cbscpe/PDP-11-CPU-V2-3/PDP-11-CPU-V2-3.kicad_pcb

## KiCad design PDP-11-CPU-V2-3.kicad_pcb (2026-11-02)

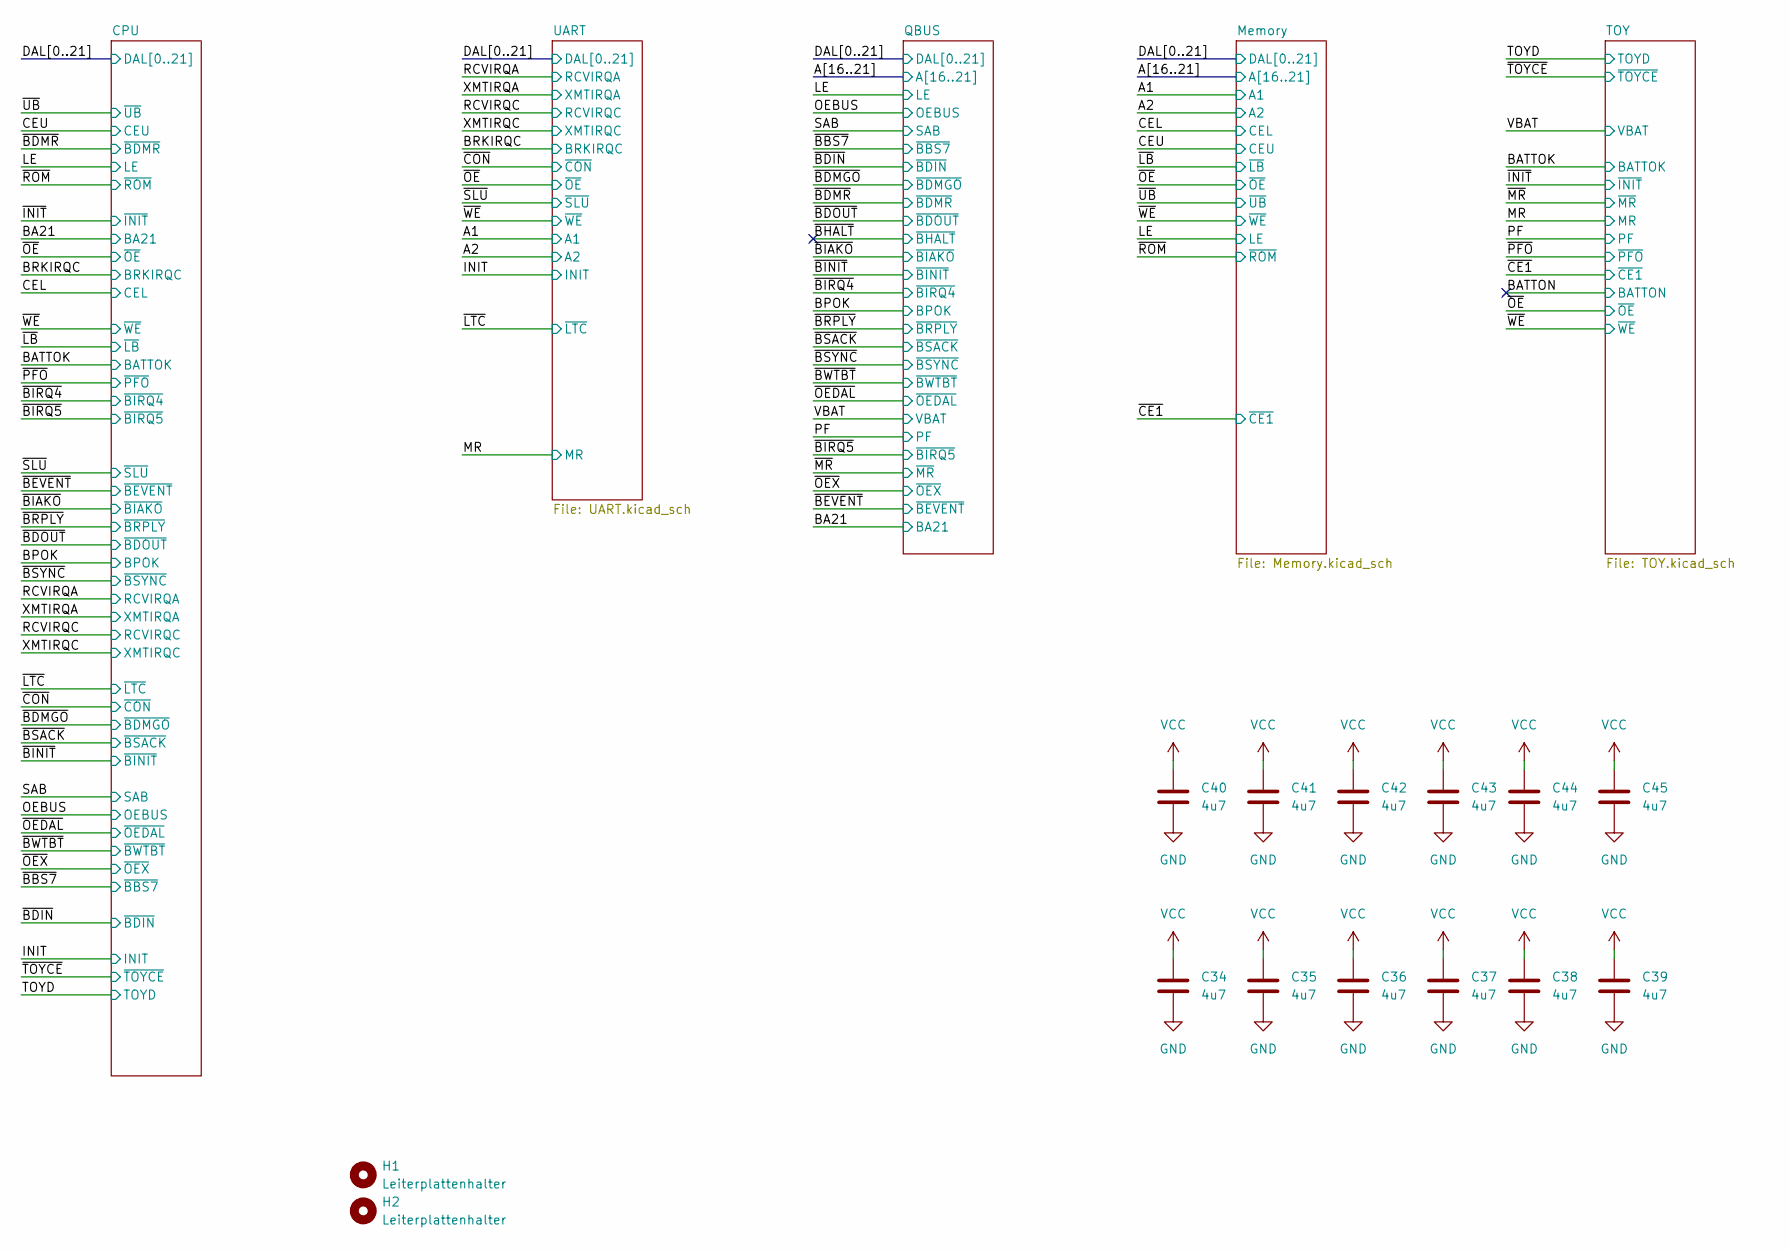
[picture p1: schematic PDP-11-CPU-V2-3.kicad_sch, Modular PDP-11/Hack CPU V2-3]

Parts:
C34, C35, C36, C37, C38, C39, C40, C41, C42, C43, C44, C45: 4u7; CP_EIA-3528-12_Kemet-T_HandSolder
H1, H2: Leiterplattenhalter; MountingHole_2.7mm_M2.5_DIN965

Connections:
GND: C34.2, C35.2, C36.2, C37.2, C38.2, C39.2, C40.2, C41.2, C42.2, C43.2, C44.2, C45.2; also elsewhere on the board
VCC: C34.1, C35.1, C36.1, C37.1, C38.1, C39.1, C40.1, C41.1, C42.1, C43.1, C44.1, C45.1; also elsewhere on the board

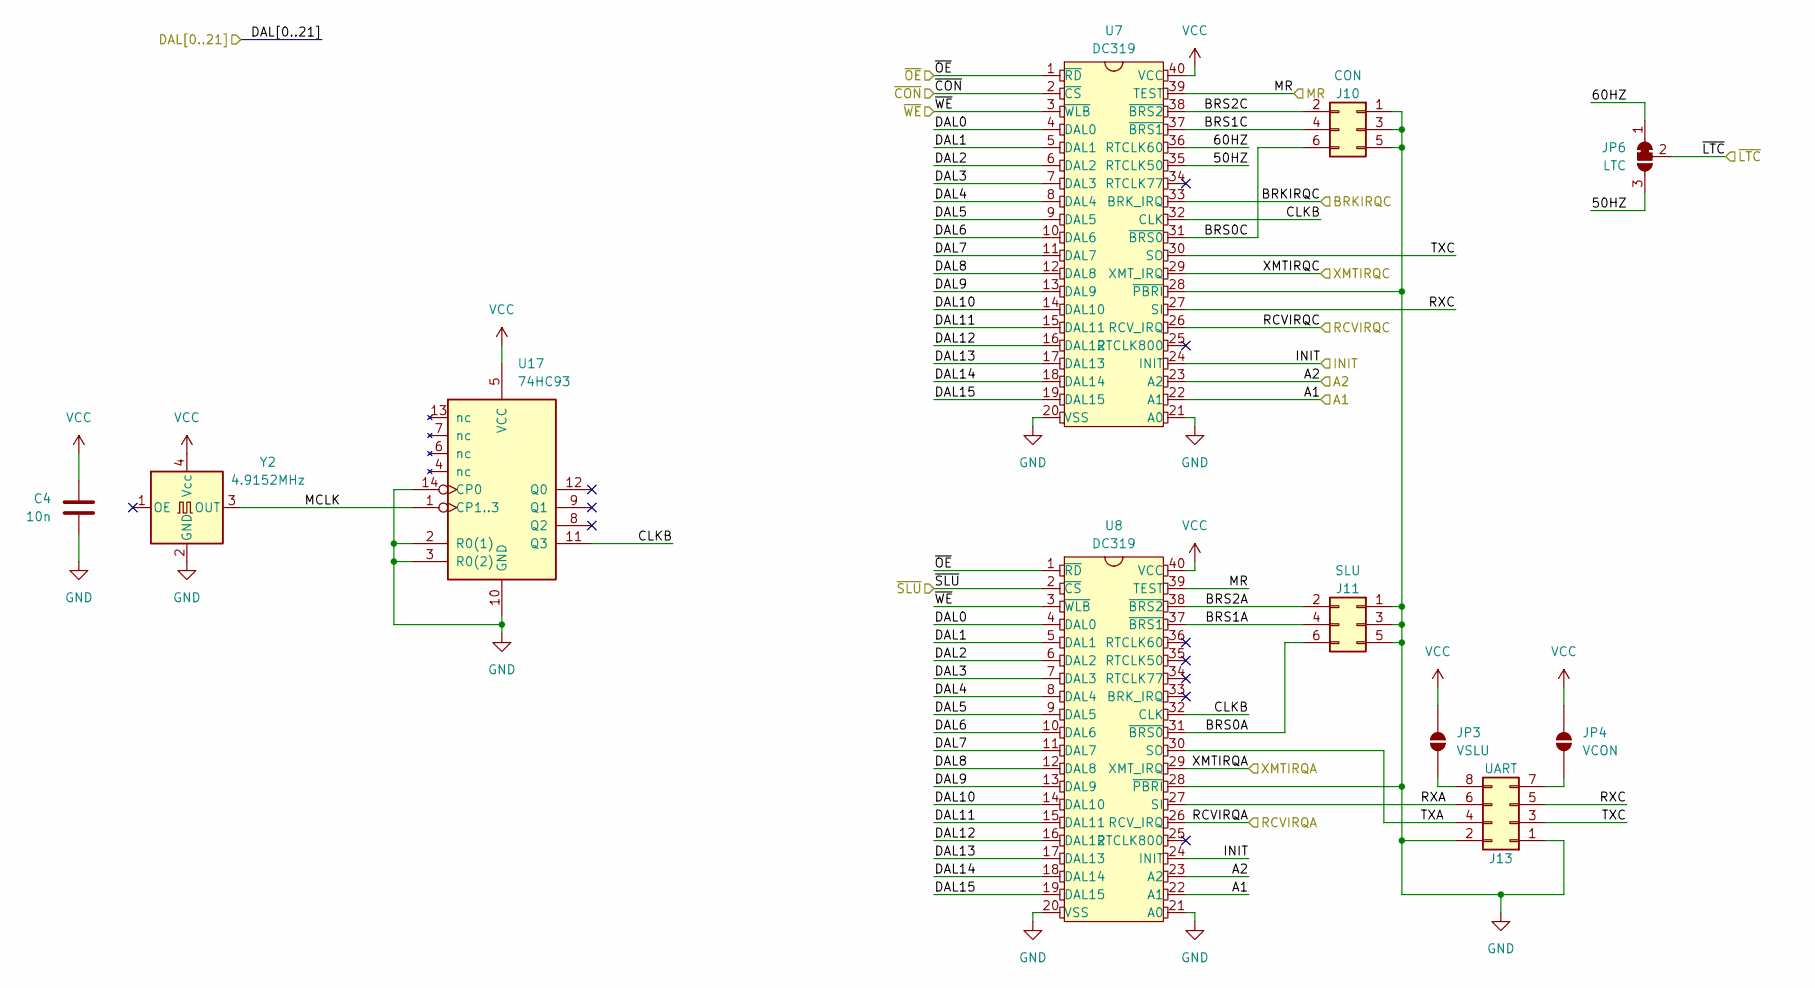
[picture p2: schematic UART.kicad_sch, Modular PDP-11/Hack CPU V2-3]

Parts:
C4: 10n; C_0603_1608Metric_Pad1.08x0.95mm_HandSolder
J10: CON; PinHeader_2x03_P2.54mm_Vertical
J11: SLU; PinHeader_2x03_P2.54mm_Vertical
J13: UART; PinHeader_2x04_P2.54mm_Horizontal
JP3: VSLU; SolderJumper-2_P1.3mm_Open_RoundedPad1.0x1.5mm
JP4: VCON; SolderJumper-2_P1.3mm_Open_RoundedPad1.0x1.5mm
JP6: LTC; SolderJumper-3_P1.3mm_Bridged12_RoundedPad1.0x1.5mm
U7, U8: DC319; DIP-40_W15.24mm_Socket
U17: 74HC93; SO-14_3.9x8.65mm_P1.27mm
Y2: 4.9152MHz; Oscillator_SMD_SeikoEpson_SG8002LB-4Pin_5.0x3.2mm_HandSolde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

Connections:
/A1: U7.22 (A1), U8.22 (A1); also elsewhere on the board
/A2: U7.23 (A2), U8.23 (A2); also elsewhere on the board
/BRKIRQC: U7.33 (BRK_IRQ); also elsewhere on the board
/DAL0: U7.4 (DAL0), U8.4 (DAL0); also elsewhere on the board
/DAL1: U7.5 (DAL1), U8.5 (DAL1); also elsewhere on the board
/DAL2: U7.6 (DAL2), U8.6 (DAL2); also elsewhere on the board
/DAL3: U7.7 (DAL3), U8.7 (DAL3); also elsewhere on the board
/DAL4: U7.8 (DAL4), U8.8 (DAL4); also elsewhere on the board
/DAL5: U7.9 (DAL5), U8.9 (DAL5); also elsewhere on the board
/DAL6: U7.10 (DAL6), U8.10 (DAL6); also elsewhere on the board
/DAL7: U7.11 (DAL7), U8.11 (DAL7); also elsewhere on the board
/DAL8: U7.12 (DAL8), U8.12 (DAL8); also elsewhere on the board
/DAL9: U7.13 (DAL9), U8.13 (DAL9); also elsewhere on the board
/DAL10: U7.14 (DAL10), U8.14 (DAL10); also elsewhere on the board
/DAL11: U7.15 (DAL11), U8.15 (DAL11); also elsewhere on the board
/DAL12: U7.16 (DAL12), U8.16 (DAL12); also elsewhere on the board
/DAL13: U7.17 (DAL13), U8.17 (DAL13); also elsewhere on the board
/DAL14: U7.18 (DAL14), U8.18 (DAL14); also elsewhere on the board
/DAL15: U7.19 (DAL15), U8.19 (DAL15); also elsewhere on the board
/INIT: U7.24 (INIT), U8.24 (INIT); also elsewhere on the board
/MR: U7.39 (TEST), U8.39 (TEST); also elsewhere on the board
/RCVIRQA: U8.26 (RCV_IRQ); also elsewhere on the board
/RCVIRQC: U7.26 (RCV_IRQ); also elsewhere on the board
/UART/50HZ: JP6.3 (B), U7.35 (RTCLK50)
/UART/60HZ: JP6.1 (A), U7.36 (RTCLK60)
/UART/BRS0A: J11.6, U8.31 (~BRS0)
/UART/BRS0C: J10.6, U7.31 (~BRS0)
/UART/BRS1A: J11.4, U8.37 (~BRS1)
/UART/BRS1C: J10.4, U7.37 (~BRS1)
/UART/BRS2A: J11.2, U8.38 (~BRS2)
/UART/BRS2C: J10.2, U7.38 (~BRS2)
/UART/CLKB: U7.32 (CLK), U8.32 (CLK), U17.11 (Q3)
/UART/MCLK: U17.1 (CP1..3), Y2.3 (OUT)
/UART/RXA: J13.6, U8.27 (SI)
/UART/RXC: J13.5, U7.27 (SI)
/UART/TXA: J13.4, U8.30 (SO)
/UART/TXC: J13.3, U7.30 (SO)
/XMTIRQA: U8.29 (XMT_IRQ); also elsewhere on the board
/XMTIRQC: U7.29 (XMT_IRQ); also elsewhere on the board
/~CON: U7.2 (~CS); also elsewhere on the board
/~LTC: JP6.2 (C); also elsewhere on the board
/~OE: U7.1 (~RD), U8.1 (~RD); also elsewhere on the board
/~SLU: U8.2 (~CS); also elsewhere on the board
/~WE: U7.3 (~WLB), U8.3 (~WLB); also elsewhere on the board
GND: C4.2, J10.1, J10.3, J10.5, J11.1, J11.3, J11.5, J13.1, J13.2, U7.20 (VSS), U7.21 (A0), U7.28 (~PBRI), U8.20 (VSS), U8.21 (A0), U8.28 (~PBRI), U17.2 (R0(1)), U17.3 (R0(2)), U17.10 (GND), U17.14 (CP0), Y2.2 (GND); also elsewhere on the board
unnamed: J13.7, JP4.1 (A)
unnamed: J13.8, JP3.1 (A)
VCC: C4.1, JP3.2 (B), JP4.2 (B), U7.40 (VCC), U8.40 (VCC), U17.5 (VCC), Y2.4 (Vcc); also elsewhere on the board

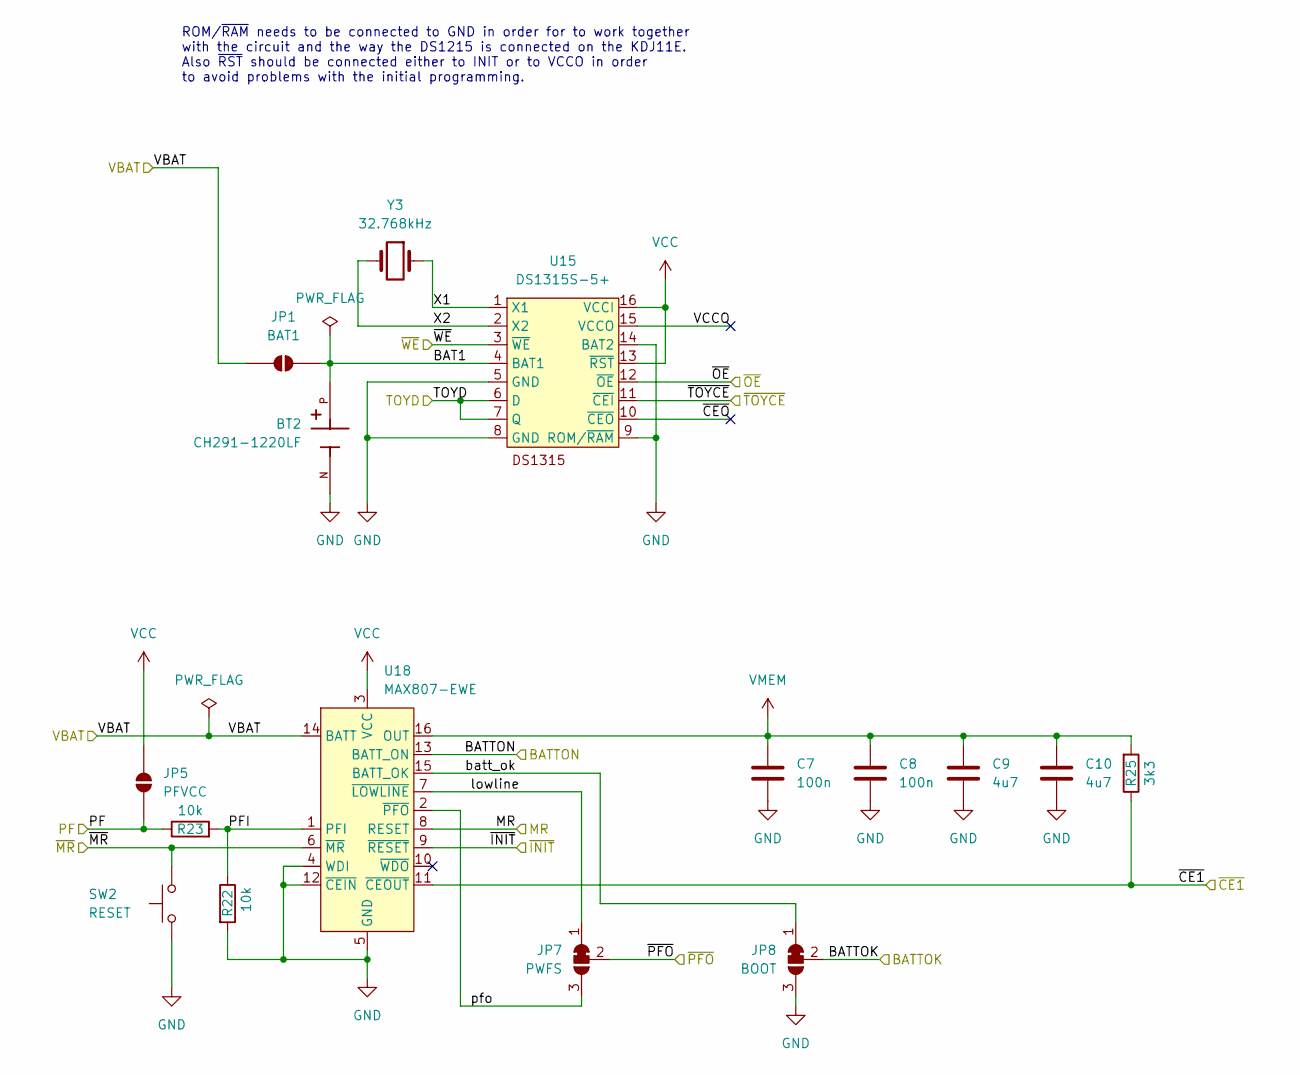
[picture p3: schematic TOY.kicad_sch, Modular PDP-11/Hack CPU V2-3]

Parts:
BT2: CH291-1220LF; BAT_CH291-1220LF
C7, C8: 100n; C_0603_1608Metric_Pad1.08x0.95mm_HandSolder
C9, C10: 4u7; CP_EIA-3528-12_Kemet-T_HandSolder
JP1: BAT1; SolderJumper-2_P1.3mm_Open_RoundedPad1.0x1.5mm
JP5: PFVCC; SolderJumper-2_P1.3mm_Open_RoundedPad1.0x1.5mm
JP7: PWFS; SolderJumper-3_P1.3mm_Bridged12_RoundedPad1.0x1.5mm
JP8: BOOT; SolderJumper-3_P1.3mm_Bridged12_RoundedPad1.0x1.5mm
R22, R23: 10k; R_0603_1608Metric_Pad0.98x0.95mm_HandSolder
R25: 3k3; R_0603_1608Metric_Pad0.98x0.95mm_HandSolder
SW2: RESET; SW_PUSH_6mm
U15: DS1315S-5+; SOIC-16W_7.5x10.3mm_P1.27mm
U18: MAX807-EWE; SOIC-16W_7.5x10.3mm_P1.27mm
Y3: 32.768kHz; Crystal_SMD_EuroQuartz_EQ161-2Pin_3.2x1.5mm_HandSoldering

Connections:
/BATTOK: JP8.2 (C); also elsewhere on the board
/BATTON: U18.13 (BATT_ON)
/MR: U18.8 (RESET); also elsewhere on the board
/PF: JP5.2 (B), R23.1; also elsewhere on the board
/TOY/BAT1: BT2.P, JP1.1 (A), U15.4 (BAT1)
/TOY/PFI: R22.1, R23.2, U18.1 (PFI)
/TOY/VCCO: U15.15 (VCCO)
/TOY/X1: U15.1 (X1), Y3.1
/TOY/X2: U15.2 (X2), Y3.2
/TOY/batt_ok: JP8.1 (A), U18.15 (BATT_OK)
/TOY/lowline: JP7.1 (A), U18.7 (~LOWLINE)
/TOY/pfo: JP7.3 (B), U18.2 (~PFO)
/TOY/~CEO: U15.10 (~CEO)
/TOYD: U15.6 (D), U15.7 (Q); also elsewhere on the board
/VBAT: JP1.2 (B), U18.14 (BATT); also elsewhere on the board
/~CE1: R25.1, U18.11 (~CEOUT); also elsewhere on the board
/~INIT: U18.9 (~RESET); also elsewhere on the board
/~MR: SW2.2, U18.6 (~MR); also elsewhere on the board
/~OE: U15.12 (~OE); also elsewhere on the board
/~PFO: JP7.2 (C); also elsewhere on the board
/~TOYCE: U15.11 (~CEI); also elsewhere on the board
/~WE: U15.3 (~WE); also elsewhere on the board
GND: BT2.N, C7.2, C8.2, C9.2, C10.2, JP8.3 (B), R22.2, SW2.1, U15.5 (GND), U15.8 (GND), U15.9 (ROM/~RAM), U15.14 (BAT2), U18.4 (WDI), U18.5 (GND), U18.12 (~CEIN); also elsewhere on the board
VCC: JP5.1 (A), U15.13 (~RST), U15.16 (VCCI), U18.3 (VCC); also elsewhere on the board
VMEM: C7.1, C8.1, C9.1, C10.1, R25.2, U18.16 (OUT); also elsewhere on the board

Notes on the sheet:
ROM/~{RAM} needs to be connected to GND in order for to work together with the circuit and the way the DS1215 is connected on the KDJ11E. Also ~{RST} should be connected either to INIT or to VCCO in order to avoid problems with the initial programming.

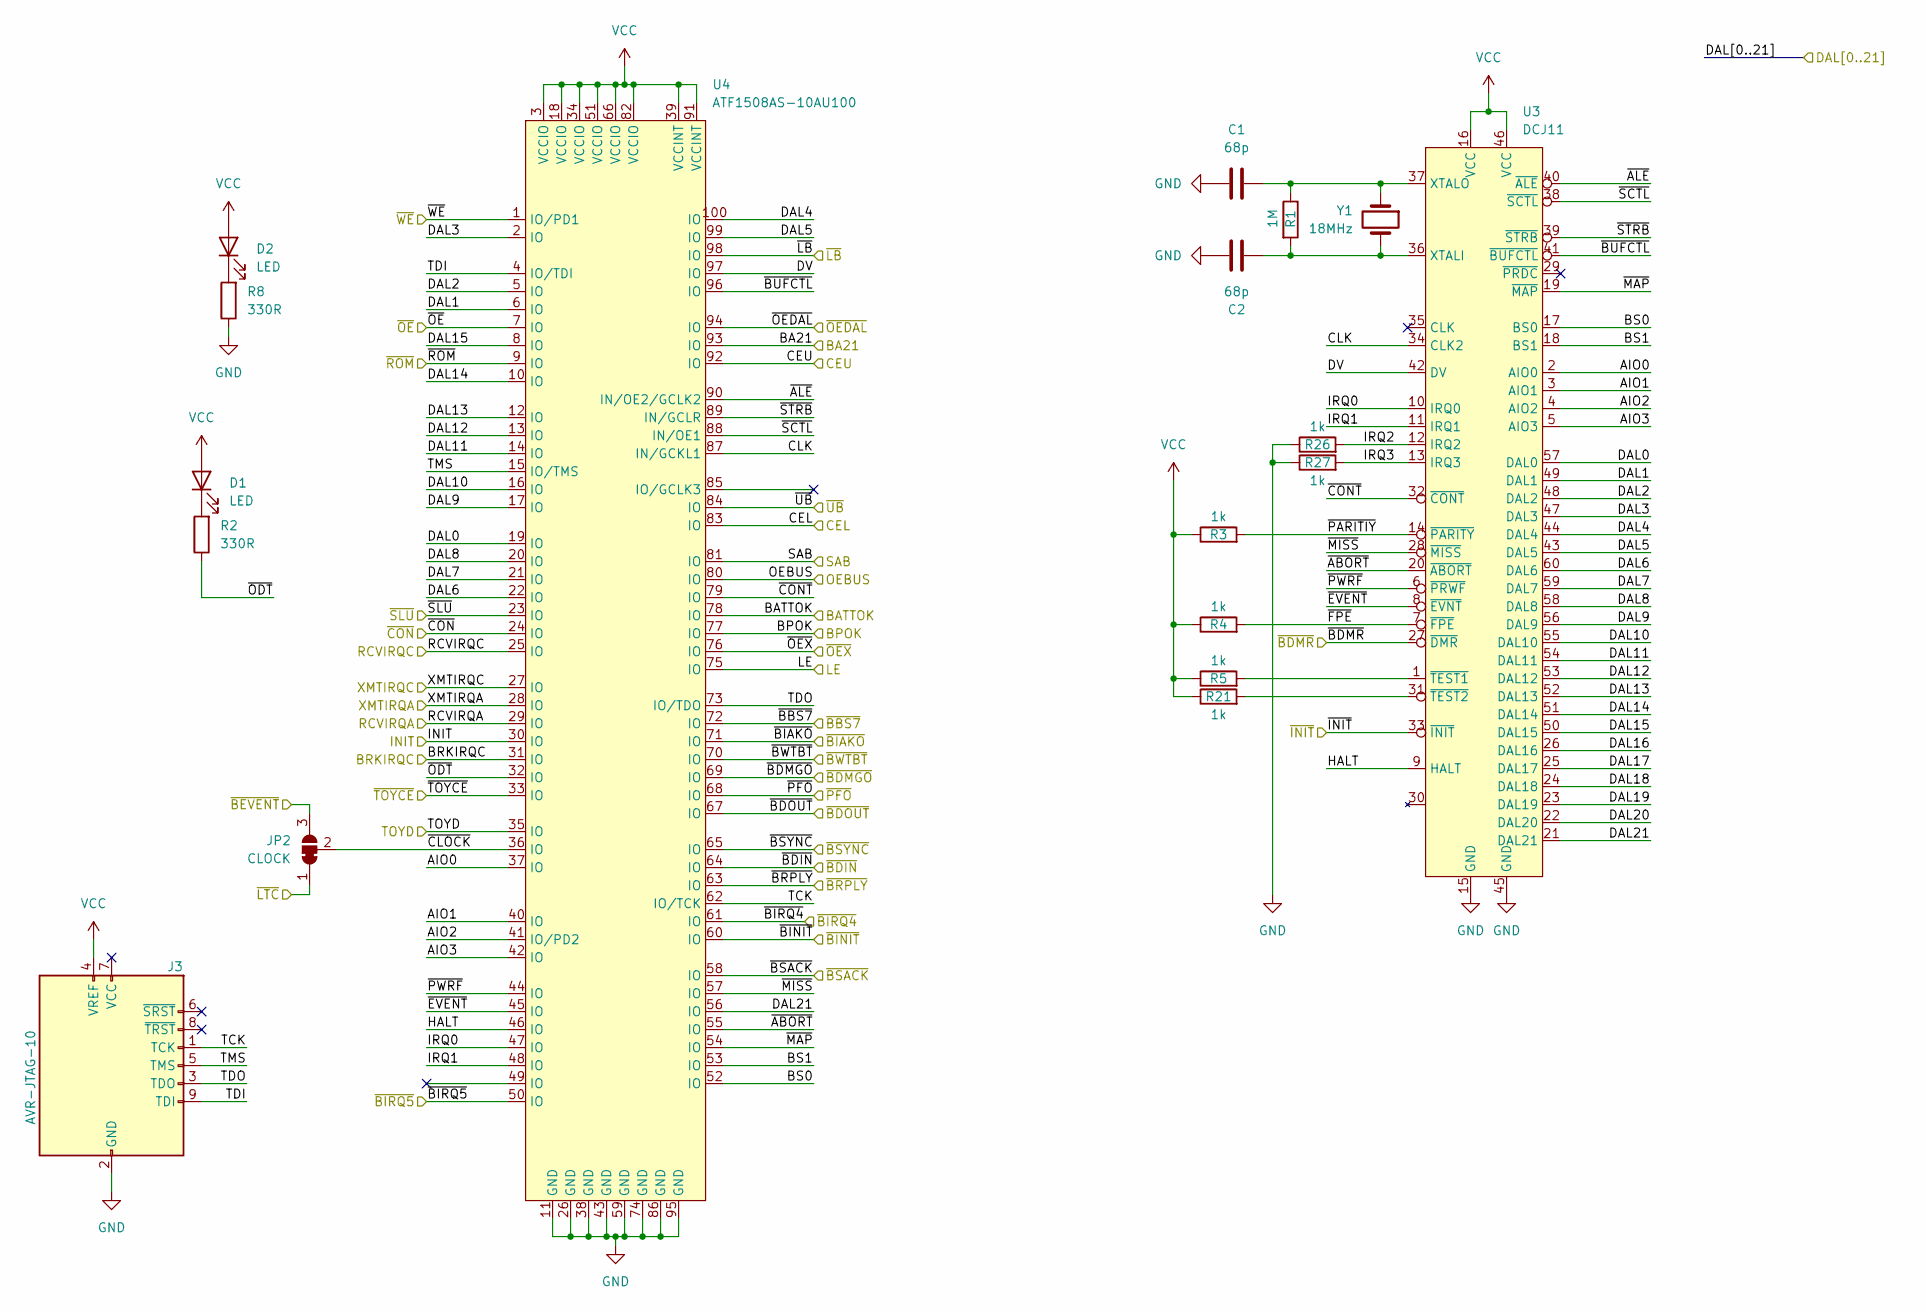
[picture p4: schematic CPU.kicad_sch, Modular PDP-11/Hack CPU V2-3]

Parts:
C1, C2: 68p; C_0603_1608Metric_Pad1.08x0.95mm_HandSolder
D1, D2: LED; LED_1206_3216Metric_Pad1.42x1.75mm_HandSolder
J3: AVR-JTAG-10; IDC-Header_2x05_P2.54mm_Horizontal
JP2: CLOCK; SolderJumper-3_P1.3mm_Bridged12_RoundedPad1.0x1.5mm
R1: 1M; R_0603_1608Metric_Pad0.98x0.95mm_HandSolder
R2, R8: 330R; R_0603_1608Metric_Pad0.98x0.95mm_HandSolder
R3, R4, R5, R21, R26, R27: 1k; R_0603_1608Metric_Pad0.98x0.95mm_HandSolder
U3: DCJ11; DIP-60_1300
U4: ATF1508AS-10AU100; TQFP-100_14x14mm_P0.5mm
Y1: 18MHz; Crystal_SMD_5032-2Pin_5.0x3.2mm_HandSoldering

Connections:
/BA21: U4.93 (IO); also elsewhere on the board
/BATTOK: U4.78 (IO); also elsewhere on the board
/BPOK: U4.77 (IO); also elsewhere on the board
/BRKIRQC: U4.31 (IO); also elsewhere on the board
/CEL: U4.83 (IO); also elsewhere on the board
/CEU: U4.92 (IO); also elsewhere on the board
/CPU/AIO0: U3.2 (AIO0), U4.37 (IO)
/CPU/AIO1: U3.3 (AIO1), U4.40 (IO)
/CPU/AIO2: U3.4 (AIO2), U4.41 (IO/PD2)
/CPU/AIO3: U3.5 (AIO3), U4.42 (IO)
/CPU/BS0: U3.17 (BS0), U4.52 (IO)
/CPU/BS1: U3.18 (BS1), U4.53 (IO)
/CPU/CLK: U3.34 (CLK2), U4.87 (IN/GCKL1)
/CPU/DV: U3.42 (DV), U4.97 (IO)
/CPU/HALT: U3.9 (HALT), U4.46 (IO)
/CPU/IRQ0: U3.10 (IRQ0), U4.47 (IO)
/CPU/IRQ1: U3.11 (IRQ1), U4.48 (IO)
/CPU/IRQ2: R26.2, U3.12 (IRQ2)
/CPU/IRQ3: R27.2, U3.13 (IRQ3)
/CPU/TCK: J3.1 (TCK), U4.62 (IO/TCK)
/CPU/TDI: J3.9 (TDI), U4.4 (IO/TDI)
/CPU/TDO: J3.3 (TDO), U4.73 (IO/TDO)
/CPU/TMS: J3.5 (TMS), U4.15 (IO/TMS)
/CPU/~ABORT: U3.20 (~ABORT), U4.55 (IO)
/CPU/~ALE: U3.40 (~ALE), U4.90 (IN/OE2/GCLK2)
/CPU/~BUFCTL: U3.41 (~BUFCTL), U4.96 (IO)
/CPU/~CLOCK: JP2.2 (C), U4.36 (IO)
/CPU/~CONT: U3.32 (~CONT), U4.79 (IO)
/CPU/~EVENT: U3.8 (~EVNT), U4.45 (IO)
/CPU/~FPE: R4.2, U3.7 (~FPE)
/CPU/~MAP: U3.19 (~MAP), U4.54 (IO)
/CPU/~MISS: U3.28 (~MISS), U4.57 (IO)
/CPU/~ODT: R2.1, U4.32 (IO)
/CPU/~PARITIY: R3.2, U3.14 (~PARITY)
/CPU/~PWRF: U3.6 (~PRWF), U4.44 (IO)
/CPU/~SCTL: U3.38 (~SCTL), U4.88 (IN/OE1)
/CPU/~STRB: U3.39 (~STRB), U4.89 (IN/GCLR)
/DAL0: U3.57 (DAL0), U4.19 (IO); also elsewhere on the board
/DAL1: U3.49 (DAL1), U4.6 (IO); also elsewhere on the board
/DAL2: U3.48 (DAL2), U4.5 (IO); also elsewhere on the board
/DAL3: U3.47 (DAL3), U4.2 (IO); also elsewhere on the board
/DAL4: U3.44 (DAL4), U4.100 (IO); also elsewhere on the board
/DAL5: U3.43 (DAL5), U4.99 (IO); also elsewhere on the board
/DAL6: U3.60 (DAL6), U4.22 (IO); also elsewhere on the board
/DAL7: U3.59 (DAL7), U4.21 (IO); also elsewhere on the board
/DAL8: U3.58 (DAL8), U4.20 (IO); also elsewhere on the board
/DAL9: U3.56 (DAL9), U4.17 (IO); also elsewhere on the board
/DAL10: U3.55 (DAL10), U4.16 (IO); also elsewhere on the board
/DAL11: U3.54 (DAL11), U4.14 (IO); also elsewhere on the board
/DAL12: U3.53 (DAL12), U4.13 (IO); also elsewhere on the board
/DAL13: U3.52 (DAL13), U4.12 (IO); also elsewhere on the board
/DAL14: U3.51 (DAL14), U4.10 (IO); also elsewhere on the board
/DAL15: U3.50 (DAL15), U4.8 (IO); also elsewhere on the board
/DAL16: U3.26 (DAL16); also elsewhere on the board
/DAL17: U3.25 (DAL17); also elsewhere on the board
/DAL18: U3.24 (DAL18); also elsewhere on the board
/DAL19: U3.23 (DAL19); also elsewhere on the board
/DAL20: U3.22 (DAL20); also elsewhere on the board
/DAL21: U3.21 (DAL21), U4.56 (IO)
/INIT: U4.30 (IO); also elsewhere on the board
/LE: U4.75 (IO); also elsewhere on the board
/OEBUS: U4.80 (IO); also elsewhere on the board
/RCVIRQA: U4.29 (IO); also elsewhere on the board
/RCVIRQC: U4.25 (IO); also elsewhere on the board
/SAB: U4.81 (IO); also elsewhere on the board
/TOYD: U4.35 (IO); also elsewhere on the board
/XMTIRQA: U4.28 (IO); also elsewhere on the board
/XMTIRQC: U4.27 (IO); also elsewhere on the board
/~BBS7: U4.72 (IO); also elsewhere on the board
/~BDIN: U4.64 (IO); also elsewhere on the board
/~BDMGO: U4.69 (IO); also elsewhere on the board
/~BDMR: U3.27 (~DMR); also elsewhere on the board
/~BDOUT: U4.67 (IO); also elsewhere on the board
/~BEVENT: JP2.3 (B); also elsewhere on the board
/~BIAKO: U4.71 (IO); also elsewhere on the board
/~BINIT: U4.60 (IO); also elsewhere on the board
/~BIRQ4: U4.61 (IO); also elsewhere on the board
/~BIRQ5: U4.50 (IO); also elsewhere on the board
/~BRPLY: U4.63 (IO); also elsewhere on the board
/~BSACK: U4.58 (IO); also elsewhere on the board
/~BSYNC: U4.65 (IO); also elsewhere on the board
/~BWTBT: U4.70 (IO); also elsewhere on the board
/~CON: U4.24 (IO); also elsewhere on the board
/~INIT: U3.33 (~INIT); also elsewhere on the board
/~LB: U4.98 (IO); also elsewhere on the board
/~LTC: JP2.1 (A); also elsewhere on the board
/~OEDAL: U4.94 (IO); also elsewhere on the board
/~OEX: U4.76 (IO); also elsewhere on the board
/~OE: U4.7 (IO); also elsewhere on the board
/~PFO: U4.68 (IO); also elsewhere on the board
/~ROM: U4.9 (IO); also elsewhere on the board
/~SLU: U4.23 (IO); also elsewhere on the board
/~TOYCE: U4.33 (IO); also elsewhere on the board
/~UB: U4.84 (IO); also elsewhere on the board
/~WE: U4.1 (IO/PD1); also elsewhere on the board
GND: C1.1, C2.1, J3.2 (GND), J3.10 (GND), R8.1, R26.1, R27.1, U3.15 (GND), U3.45 (GND), U4.11 (GND), U4.26 (GND), U4.38 (GND), U4.43 (GND), U4.59 (GND), U4.74 (GND), U4.86 (GND), U4.95 (GND); also elsewhere on the board
unnamed: D1.1 (K), R2.2
unnamed: D2.1 (K), R8.2
unnamed: C2.2, R1.2, U3.36 (XTALI), Y1.2
unnamed: C1.2, R1.1, U3.37 (XTALO), Y1.1
unnamed: R5.2, U3.1 (~TEST1)
unnamed: R21.2, U3.31 (~TEST2)
VCC: D1.2 (A), D2.2 (A), J3.4 (VREF), R3.1, R4.1, R5.1, R21.1, U3.16 (VCC), U3.46 (VCC), U4.3 (VCCIO), U4.18 (VCCIO), U4.34 (VCCIO), U4.39 (VCCINT), U4.51 (VCCIO), U4.66 (VCCIO), U4.82 (VCCIO), U4.91 (VCCINT); also elsewhere on the board

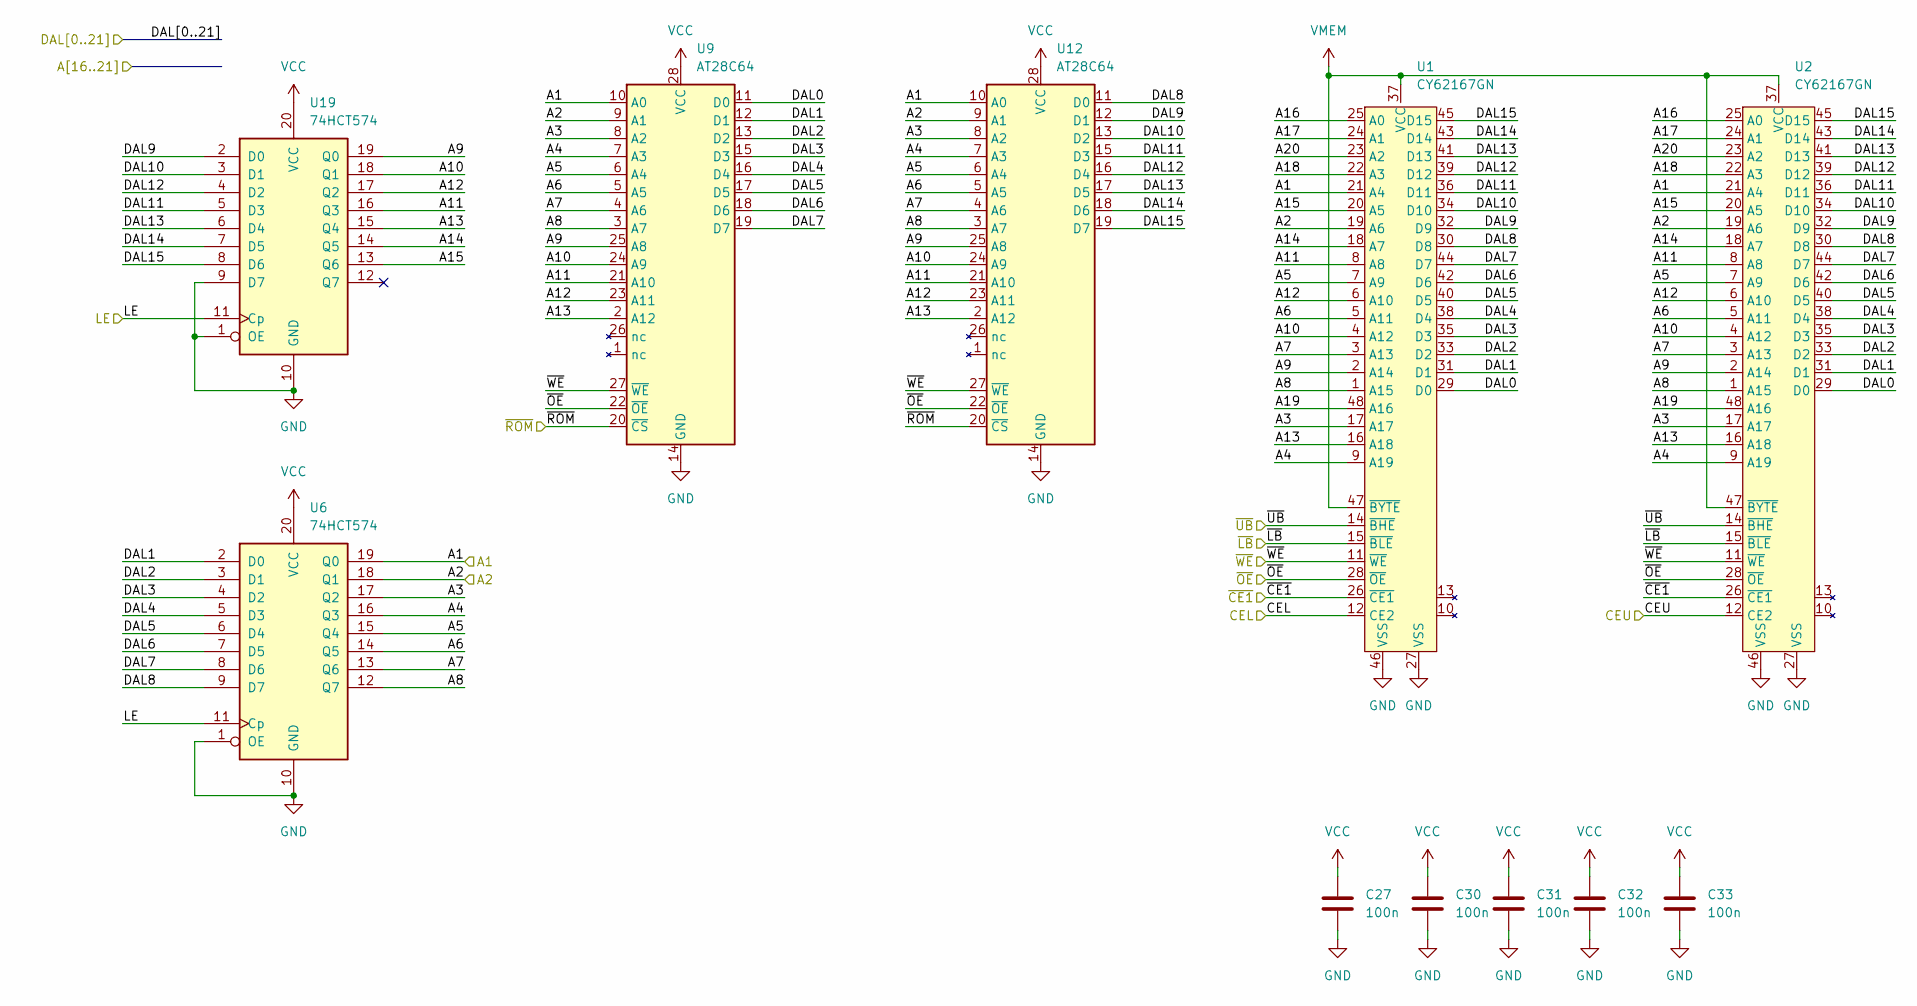
[picture p5: schematic Memory.kicad_sch, Modular PDP-11/Hack CPU V2-3]

Parts:
C27, C30, C31, C32, C33: 100n; C_0603_1608Metric_Pad1.08x0.95mm_HandSolder
U1, U2: CY62167GN; TSOP-I-48_18.4x12mm_P0.5mm
U6, U19: 74HCT574; TSSOP-20_4.4x6.5mm_P0.65mm
U9, U12: AT28C64; SOIC-28W_7.5x17.9mm_P1.27mm

Connections:
/A1: U1.21 (A4), U2.21 (A4), U6.19 (Q0), U9.10 (A0), U12.10 (A0); also elsewhere on the board
/A2: U1.19 (A6), U2.19 (A6), U6.18 (Q1), U9.9 (A1), U12.9 (A1); also elsewhere on the board
/A16: U1.25 (A0), U2.25 (A0); also elsewhere on the board
/A17: U1.24 (A1), U2.24 (A1); also elsewhere on the board
/A18: U1.22 (A3), U2.22 (A3); also elsewhere on the board
/A19: U1.48 (A16), U2.48 (A16); also elsewhere on the board
/A20: U1.23 (A2), U2.23 (A2); also elsewhere on the board
/CEL: U1.12 (CE2); also elsewhere on the board
/CEU: U2.12 (CE2); also elsewhere on the board
/DAL0: U1.29 (D0), U2.29 (D0), U9.11 (D0); also elsewhere on the board
/DAL1: U1.31 (D1), U2.31 (D1), U6.2 (D0), U9.12 (D1); also elsewhere on the board
/DAL2: U1.33 (D2), U2.33 (D2), U6.3 (D1), U9.13 (D2); also elsewhere on the board
/DAL3: U1.35 (D3), U2.35 (D3), U6.4 (D2), U9.15 (D3); also elsewhere on the board
/DAL4: U1.38 (D4), U2.38 (D4), U6.5 (D3), U9.16 (D4); also elsewhere on the board
/DAL5: U1.40 (D5), U2.40 (D5), U6.6 (D4), U9.17 (D5); also elsewhere on the board
/DAL6: U1.42 (D6), U2.42 (D6), U6.7 (D5), U9.18 (D6); also elsewhere on the board
/DAL7: U1.44 (D7), U2.44 (D7), U6.8 (D6), U9.19 (D7); also elsewhere on the board
/DAL8: U1.30 (D8), U2.30 (D8), U6.9 (D7), U12.11 (D0); also elsewhere on the board
/DAL9: U1.32 (D9), U2.32 (D9), U12.12 (D1), U19.2 (D0); also elsewhere on the board
/DAL10: U1.34 (D10), U2.34 (D10), U12.13 (D2), U19.3 (D1); also elsewhere on the board
/DAL11: U1.36 (D11), U2.36 (D11), U12.15 (D3), U19.5 (D3); also elsewhere on the board
/DAL12: U1.39 (D12), U2.39 (D12), U12.16 (D4), U19.4 (D2); also elsewhere on the board
/DAL13: U1.41 (D13), U2.41 (D13), U12.17 (D5), U19.6 (D4); also elsewhere on the board
/DAL14: U1.43 (D14), U2.43 (D14), U12.18 (D6), U19.7 (D5); also elsewhere on the board
/DAL15: U1.45 (D15), U2.45 (D15), U12.19 (D7), U19.8 (D6); also elsewhere on the board
/LE: U6.11 (Cp), U19.11 (Cp); also elsewhere on the board
/Memory/A3: U1.17 (A17), U2.17 (A17), U6.17 (Q2), U9.8 (A2), U12.8 (A2)
/Memory/A4: U1.9 (A19), U2.9 (A19), U6.16 (Q3), U9.7 (A3), U12.7 (A3)
/Memory/A5: U1.7 (A9), U2.7 (A9), U6.15 (Q4), U9.6 (A4), U12.6 (A4)
/Memory/A6: U1.5 (A11), U2.5 (A11), U6.14 (Q5), U9.5 (A5), U12.5 (A5)
/Memory/A7: U1.3 (A13), U2.3 (A13), U6.13 (Q6), U9.4 (A6), U12.4 (A6)
/Memory/A8: U1.1 (A15), U2.1 (A15), U6.12 (Q7), U9.3 (A7), U12.3 (A7)
/Memory/A9: U1.2 (A14), U2.2 (A14), U9.25 (A8), U12.25 (A8), U19.19 (Q0)
/Memory/A10: U1.4 (A12), U2.4 (A12), U9.24 (A9), U12.24 (A9), U19.18 (Q1)
/Memory/A11: U1.8 (A8), U2.8 (A8), U9.21 (A10), U12.21 (A10), U19.16 (Q3)
/Memory/A12: U1.6 (A10), U2.6 (A10), U9.23 (A11), U12.23 (A11), U19.17 (Q2)
/Memory/A13: U1.16 (A18), U2.16 (A18), U9.2 (A12), U12.2 (A12), U19.15 (Q4)
/Memory/A14: U1.18 (A7), U2.18 (A7), U19.14 (Q5)
/Memory/A15: U1.20 (A5), U2.20 (A5), U19.13 (Q6)
/~CE1: U1.26 (~CE1), U2.26 (~CE1); also elsewhere on the board
/~LB: U1.15 (~BLE), U2.15 (~BLE); also elsewhere on the board
/~OE: U1.28 (~OE), U2.28 (~OE), U9.22 (~OE), U12.22 (~OE); also elsewhere on the board
/~ROM: U9.20 (~CS), U12.20 (~CS); also elsewhere on the board
/~UB: U1.14 (~BHE), U2.14 (~BHE); also elsewhere on the board
/~WE: U1.11 (~WE), U2.11 (~WE), U9.27 (~WE), U12.27 (~WE); also elsewhere on the board
GND: C27.2, C30.2, C31.2, C32.2, C33.2, U1.27 (VSS), U1.46 (VSS), U2.27 (VSS), U2.46 (VSS), U6.1 (OE), U6.10 (GND), U9.14 (GND), U12.14 (GND), U19.1 (OE), U19.9 (D7), U19.10 (GND); also elsewhere on the board
VCC: C27.1, C30.1, C31.1, C32.1, C33.1, U6.20 (VCC), U9.28 (VCC), U12.28 (VCC), U19.20 (VCC); also elsewhere on the board
VMEM: U1.37 (VCC), U1.47 (~BYTE), U2.37 (VCC), U2.47 (~BYTE); also elsewhere on the board
