cbscpe/PDP-11-CPU-V2-3/PDP-11-CPU-V2-3.kicad_pcb

## KiCad design PDP-11-CPU-V2-3.kicad_pcb (continued)

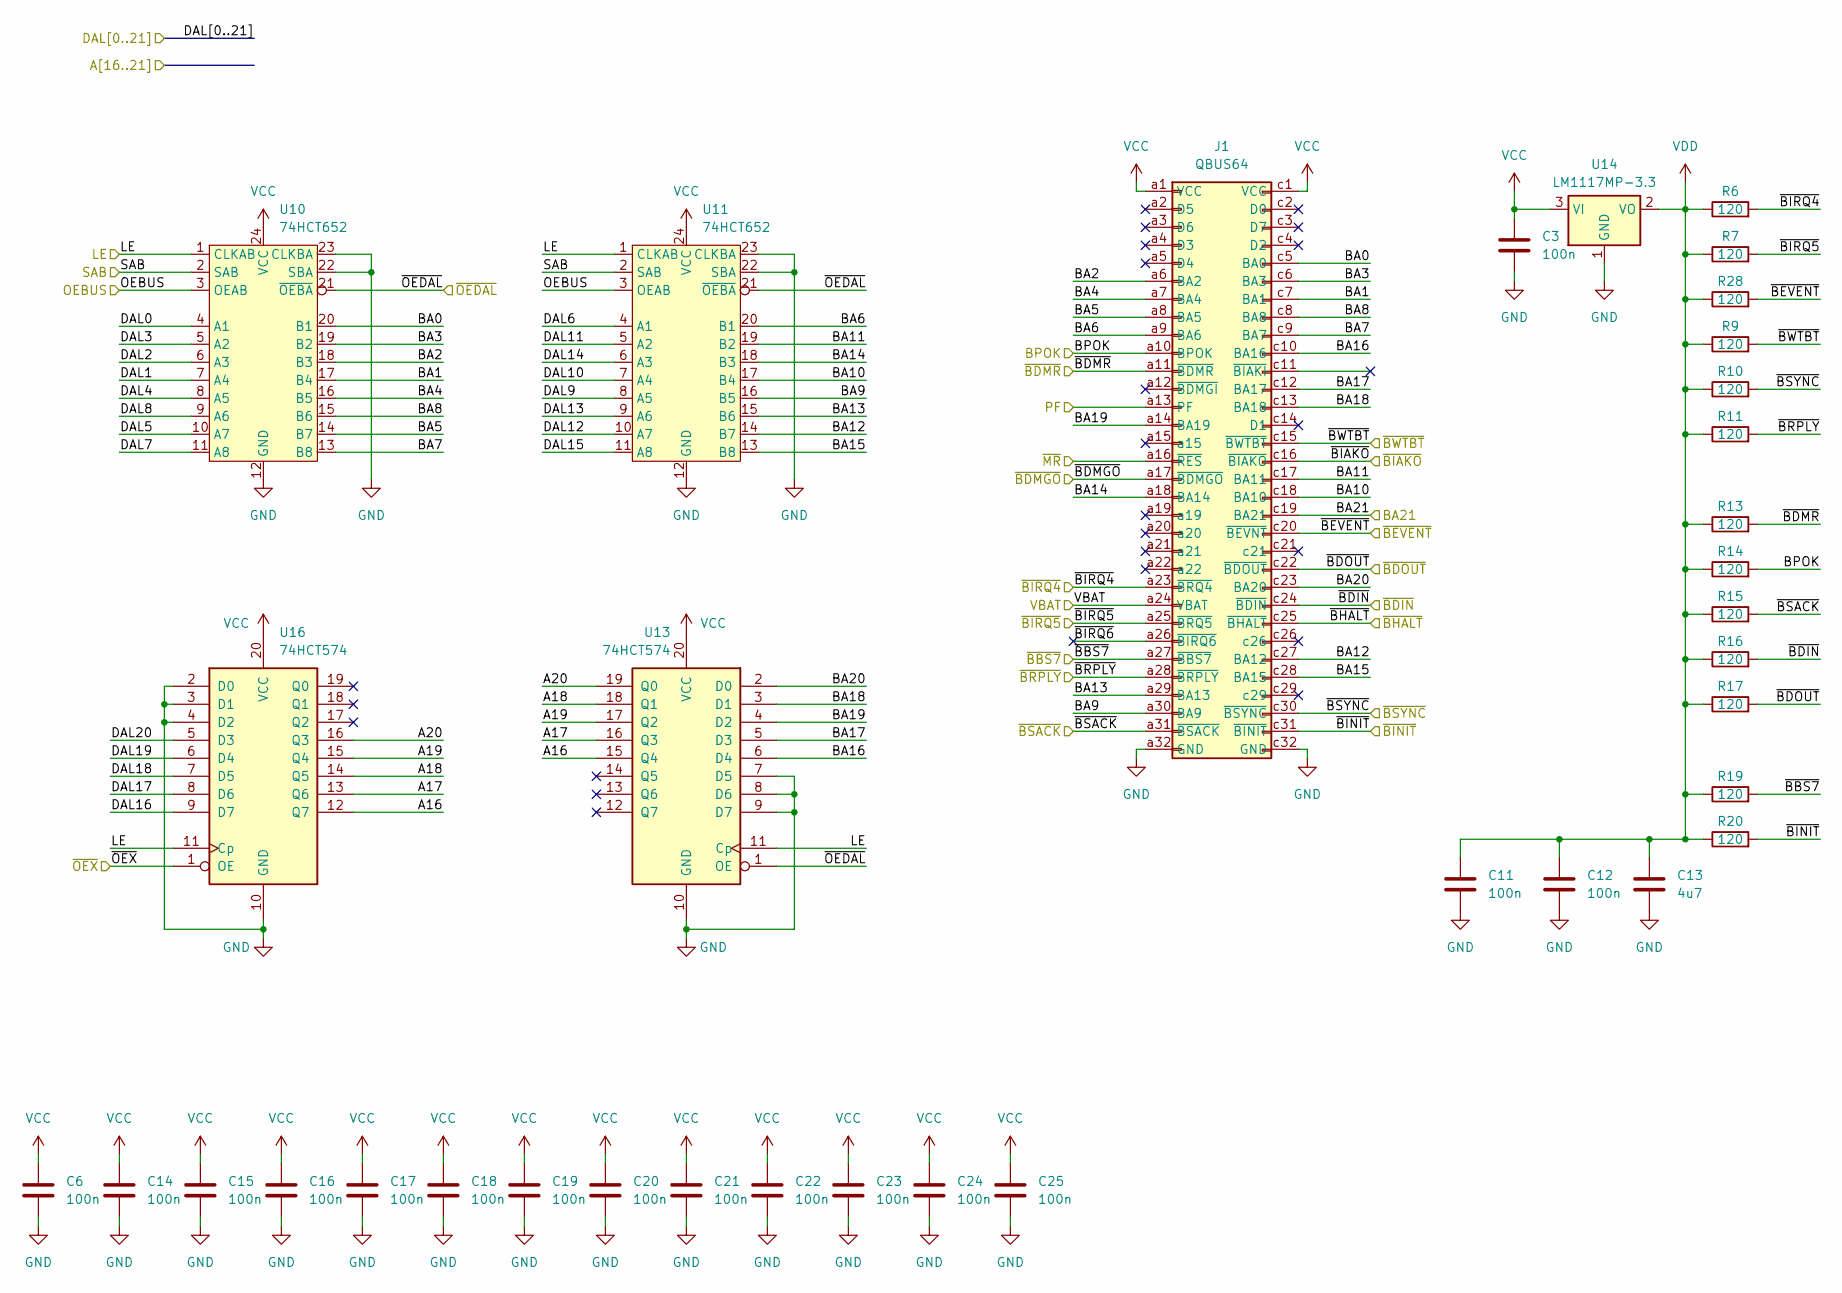
[picture p6: schematic QBUS.kicad_sch, Modular PDP-11/Hack CPU V2-3]

Parts:
C3, C6, C11, C12, C14, C15, C16, C17, C18, C19, C20, C21, C22, C23, C24, C25: 100n; C_0603_1608Metric_Pad1.08x0.95mm_HandSolder
C13: 4u7; CP_EIA-3528-12_Kemet-T_HandSolder
J1: QBUS64; DIN41612_C_2x32_Male_Horizontal_THT
R6, R7, R9, R10, R11, R13, R14, R15, R16, R17, R19, R20, R28: 120; R_0603_1608Metric_Pad0.98x0.95mm_HandSolder
U10, U11: 74HCT652; SOIC-24W_7.5x15.4mm_P1.27mm
U13, U16: 74HCT574; TSSOP-20_4.4x6.5mm_P0.65mm
U14: LM1117MP-3.3; SOT-223-3_TabPin2

Connections:
/A16: U13.15 (Q4), U16.12 (Q7); also elsewhere on the board
/A17: U13.16 (Q3), U16.13 (Q6); also elsewhere on the board
/A18: U13.18 (Q1), U16.14 (Q5); also elsewhere on the board
/A19: U13.17 (Q2), U16.15 (Q4); also elsewhere on the board
/A20: U13.19 (Q0), U16.16 (Q3); also elsewhere on the board
/BA21: J1.c19 (BA21); also elsewhere on the board
/BPOK: J1.a10 (BPOK), R14.2; also elsewhere on the board
/DAL0: U10.4 (A1); also elsewhere on the board
/DAL1: U10.7 (A4); also elsewhere on the board
/DAL2: U10.6 (A3); also elsewhere on the board
/DAL3: U10.5 (A2); also elsewhere on the board
/DAL4: U10.8 (A5); also elsewhere on the board
/DAL5: U10.10 (A7); also elsewhere on the board
/DAL6: U11.4 (A1); also elsewhere on the board
/DAL7: U10.11 (A8); also elsewhere on the board
/DAL8: U10.9 (A6); also elsewhere on the board
/DAL9: U11.8 (A5); also elsewhere on the board
/DAL10: U11.7 (A4); also elsewhere on the board
/DAL11: U11.5 (A2); also elsewhere on the board
/DAL12: U11.10 (A7); also elsewhere on the board
/DAL13: U11.9 (A6); also elsewhere on the board
/DAL14: U11.6 (A3); also elsewhere on the board
/DAL15: U11.11 (A8); also elsewhere on the board
/DAL16: U16.9 (D7); also elsewhere on the board
/DAL17: U16.8 (D6); also elsewhere on the board
/DAL18: U16.7 (D5); also elsewhere on the board
/DAL19: U16.6 (D4); also elsewhere on the board
/DAL20: U16.5 (D3); also elsewhere on the board
/LE: U10.1 (CLKAB), U11.1 (CLKAB), U13.11 (Cp), U16.11 (Cp); also elsewhere on the board
/OEBUS: U10.3 (OEAB), U11.3 (OEAB); also elsewhere on the board
/PF: J1.a13 (PF); also elsewhere on the board
/QBUS/BA0: J1.c5 (BA0), U10.20 (B1)
/QBUS/BA1: J1.c7 (BA1), U10.17 (B4)
/QBUS/BA2: J1.a6 (BA2), U10.18 (B3)
/QBUS/BA3: J1.c6 (BA3), U10.19 (B2)
/QBUS/BA4: J1.a7 (BA4), U10.16 (B5)
/QBUS/BA5: J1.a8 (BA5), U10.14 (B7)
/QBUS/BA6: J1.a9 (BA6), U11.20 (B1)
/QBUS/BA7: J1.c9 (BA7), U10.13 (B8)
/QBUS/BA8: J1.c8 (BA8), U10.15 (B6)
/QBUS/BA9: J1.a30 (BA9), U11.16 (B5)
/QBUS/BA10: J1.c18 (BA10), U11.17 (B4)
/QBUS/BA11: J1.c17 (BA11), U11.19 (B2)
/QBUS/BA12: J1.c27 (BA12), U11.14 (B7)
/QBUS/BA13: J1.a29 (BA13), U11.15 (B6)
/QBUS/BA14: J1.a18 (BA14), U11.18 (B3)
/QBUS/BA15: J1.c28 (BA15), U11.13 (B8)
/QBUS/BA16: J1.c10 (BA16), U13.6 (D4)
/QBUS/BA17: J1.c12 (BA17), U13.5 (D3)
/QBUS/BA18: J1.c13 (BA18), U13.3 (D1)
/QBUS/BA19: J1.a14 (BA19), U13.4 (D2)
/QBUS/BA20: J1.c23 (BA20), U13.2 (D0)
/QBUS/~BIRQ6: J1.a26 (~BIRQ6)
/SAB: U10.2 (SAB), U11.2 (SAB); also elsewhere on the board
/VBAT: J1.a24 (VBAT); also elsewhere on the board
/~BBS7: J1.a27 (~BBS7), R19.2; also elsewhere on the board
/~BDIN: J1.c24 (~BDIN), R16.2; also elsewhere on the board
/~BDMGO: J1.a17 (~BDMGO); also elsewhere on the board
/~BDMR: J1.a11 (~BDMR), R13.2; also elsewhere on the board
/~BDOUT: J1.c22 (~BDOUT), R17.2; also elsewhere on the board
/~BEVENT: J1.c20 (~BEVNT), R28.2; also elsewhere on the board
/~BHALT: J1.c25 (~BHALT)
/~BIAKO: J1.c16 (~BIAKO); also elsewhere on the board
/~BINIT: J1.c31 (~BINIT), R20.2; also elsewhere on the board
/~BIRQ4: J1.a23 (~BRQ4), R6.2; also elsewhere on the board
/~BIRQ5: J1.a25 (~BRQ5), R7.2; also elsewhere on the board
/~BRPLY: J1.a28 (~BRPLY), R11.2; also elsewhere on the board
/~BSACK: J1.a31 (~BSACK), R15.2; also elsewhere on the board
/~BSYNC: J1.c30 (~BSYNC), R10.2; also elsewhere on the board
/~BWTBT: J1.c15 (~BWTBT), R9.2; also elsewhere on the board
/~MR: J1.a16 (~RES); also elsewhere on the board
/~OEDAL: U10.21 (~OEBA), U11.21 (~OEBA), U13.1 (OE); also elsewhere on the board
/~OEX: U16.1 (OE); also elsewhere on the board
GND: C3.2, C6.2, C11.2, C12.2, C13.2, C14.2, C15.2, C16.2, C17.2, C18.2, C19.2, C20.2, C21.2, C22.2, C23.2, C24.2, C25.2, J1.a32 (GND), J1.c32 (GND), U10.12 (GND), U10.22 (SBA), U10.23 (CLKBA), U11.12 (GND), U11.22 (SBA), U11.23 (CLKBA), U13.7 (D5), U13.8 (D6), U13.9 (D7), U13.10 (GND), U14.1 (GND), U16.2 (D0), U16.3 (D1), U16.4 (D2), U16.10 (GND); also elsewhere on the board
VCC: C3.1, C6.1, C14.1, C15.1, C16.1, C17.1, C18.1, C19.1, C20.1, C21.1, C22.1, C23.1, C24.1, C25.1, J1.a1 (VCC), J1.c1 (VCC), U10.24 (VCC), U11.24 (VCC), U13.20 (VCC), U14.3 (VI), U16.20 (VCC); also elsewhere on the board
VDD: C11.1, C12.1, C13.1, R6.1, R7.1, R9.1, R10.1, R11.1, R13.1, R14.1, R15.1, R16.1, R17.1, R19.1, R20.1, R28.1, U14.2 (VO)

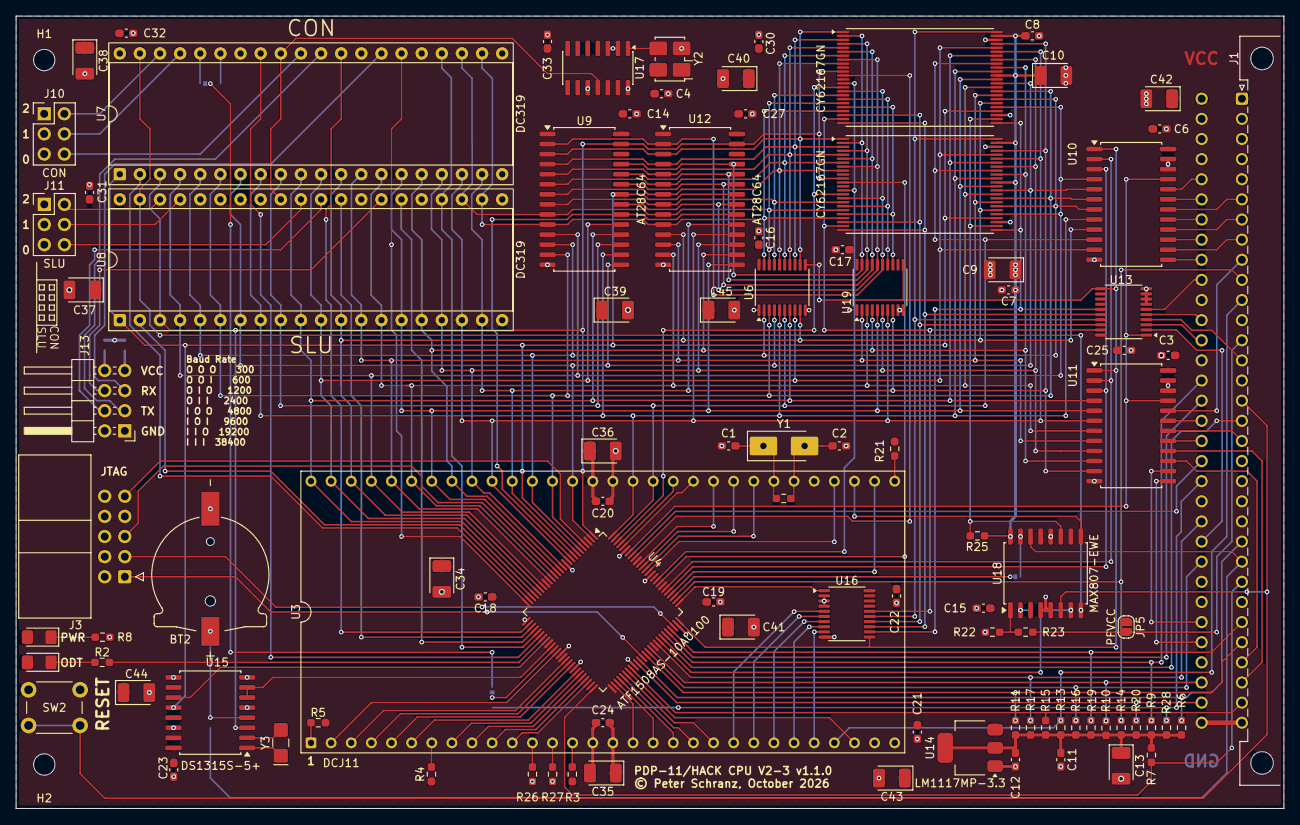
[picture p7: board PDP-11-CPU-V2-3.kicad_pcb from above]

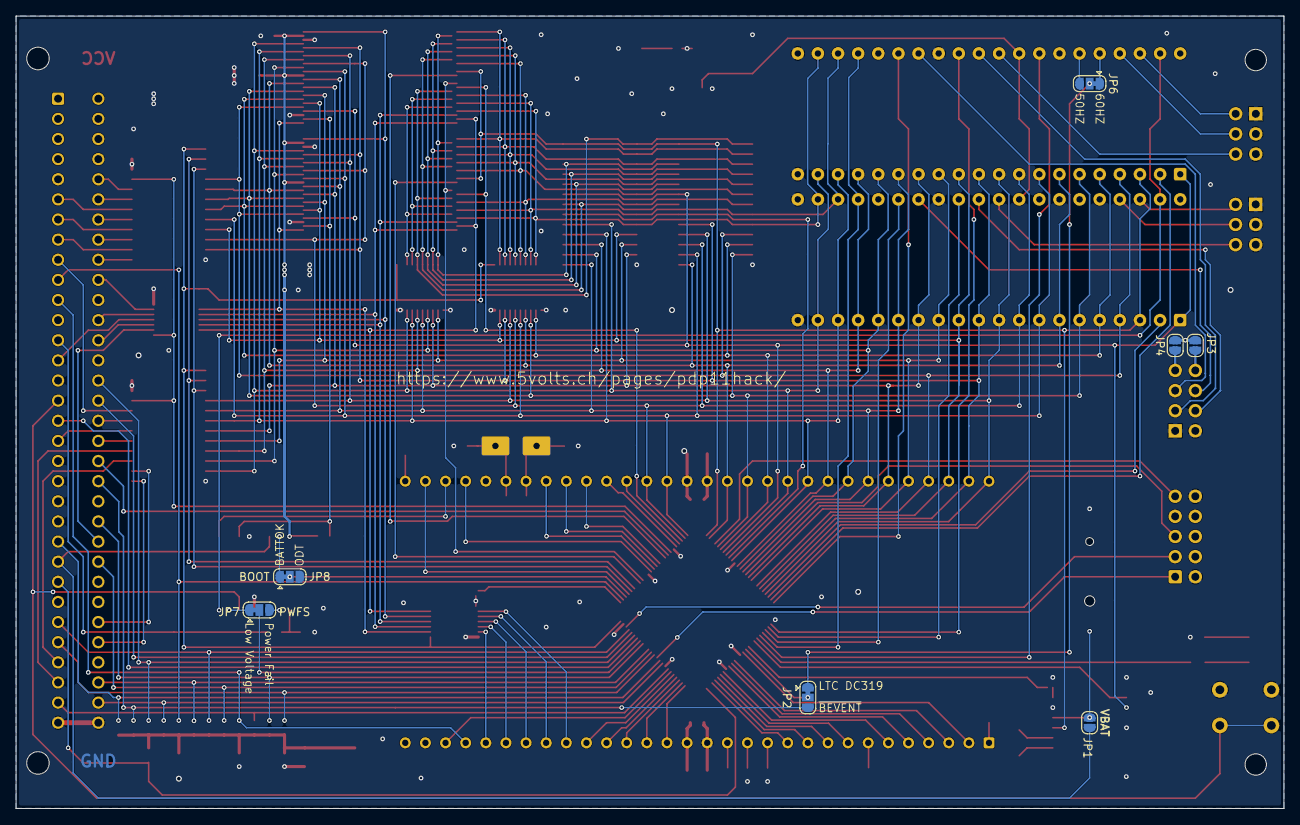
[picture p8: board PDP-11-CPU-V2-3.kicad_pcb from below]

Board: 2 copper layers, 160.0 x 100.0 mm, 106 parts (7 on the bottom side), 174 nets.
