cbscpe/PDP-11-CPU-V2-3/(commit log)

2026-06-27 New Page with CPU and Main CPLD
    [CPU.kicad_sch, PDP-11-CPU-V2-2.kicad_pcb, PDP-11-CPU-V2-2.kicad_sch]
2026-06-28 Route PF and MR differently
    [PDP-11-CPU-V2-2.kicad_pcb, PDP-11-CPU-V2-2.kicad_sch, UART.kicad_sch]
2026-06-28 Connect BA21 to U13 and DAL21 to U16 and use the muxed output to connect as A21 to the ATF1508
    [CPU.kicad_sch, PDP-11-CPU-V2-2.kicad_pcb, PDP-11-CPU-V2-2.kicad_sch, QBUS.kicad_sch]
2026-06-28 Reroute PF, MR
    [PDP-11-CPU-V2-2.kicad_pcb]
2026-09-22 Replace IDE JTAG with new 6-pin PCB only footprint
    [CPU.kicad_sch, Memory.kicad_sch, PDP-11-CPU-V2-2.kicad_pcb, PDP-11-CPU-V2-3.kicad_pcb, PDP-11-CPU-V2-3.kicad_sch, QBUS.kicad_sch, TOY.kicad_sch, UART.kicad_sch]
2026-09-24 Swap CLKB and CLOCK, place BINIT to pin 60 and BIRQ4 to pin 61
    [CPU.kicad_sch, PDP-11-CPU-V2-3.kicad_pcb]
2026-09-24 Minor corrections
    [PDP-11-CPU-V2-3.kicad_pcb, QBUS.kicad_sch]
2026-09-25 Before moving the MAX807 the following steps have been performed to make space for the new place of the MAX807 - swapped U13 and U11 for short tracks to BAxx - replaced JTAG with standard 10-pin IDE 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
    [CPU.kicad_sch, Memory.kicad_sch, PDP-11-CPU-V2-3.kicad_pcb, QBUS.kicad_sch, TOY.kicad_sch]
2026-09-25 Move MAX807 near to the DCJ11, route external MR and swap ODT and PWR LEDs with RESET switch
    [PDP-11-CPU-V2-3.kicad_pcb]
2026-09-26 Finish new layout
    [PDP-11-CPU-V2-3.kicad_pcb]
2026-09-26 New RAM and EEPROM placement - EEPROM are now rotated by 90° to make for more natural routing of data lines - RAM and address latches are slightly moved and address lines have been swapped to match n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
    [Memory.kicad_sch, PDP-11-CPU-V2-3.kicad_pcb]
2026-09-27 Reroute A13 and remove unnecessary VIAs for A9-13 originating from U19
    [PDP-11-CPU-V2-3.kicad_pcb]
2026-10-02 Place baud-rate generation above EEPROM and remove baud-rate counter from CPLD
    [CPU.kicad_sch, Memory.kicad_sch, PDP-11-CPU-V2-3.kicad_pcb, PDP-11-CPU-V2-3.kicad_sch, QBUS.kicad_sch, TOY.kicad_sch, UART.kicad_sch]
2026-10-02 Check placemenet of decoupling capacitors and release for manufacturing
    [PDP-11-CPU-V2-3.kicad_pcb]
2026-10-09 Add connection from BRKIRQC to the CPLD
    [CPU.kicad_sch, PDP-11-CPU-V2-3.kicad_pcb, PDP-11-CPU-V2-3.kicad_sch]
2026-10-13 move via of C1, tried to add wholes for TH crystal Y1, did not work out well
    [PDP-11-CPU-V2-3.kicad_pcb]
2026-10-15 change value of R25 to 3k3
    [PDP-11-CPU-V2-3.kicad_pcb, TOY.kicad_sch]
2026-10-15 Add Text for Solder Jumpers LTC and PF
    [PDP-11-CPU-V2-3.kicad_pcb]
2026-10-18 Intermediate Save with only little change due to fill areas
    [PDP-11-CPU-V2-3.kicad_pcb]
2026-10-18 correct wrong connections of A17..A20 on U16 and BA6, BA9..BA15 on U11
    [PDP-11-CPU-V2-3.kicad_pcb, QBUS.kicad_sch]
2026-10-19 Clean-up and remove unused decoupling capacitors
    [CPU.kicad_sch, Memory.kicad_sch, PDP-11-CPU-V2-3.kicad_pcb, QBUS.kicad_sch]
2026-10-19 Add solder jumper to connect PF to VCC and add solder jumper to force boot into ODT
    [PDP-11-CPU-V2-3.kicad_pcb, TOY.kicad_sch]
2026-10-20 Use 50Hz and 60Hz output of Console DC319 instead SLU DC319
    [PDP-11-CPU-V2-3.kicad_pcb, UART.kicad_sch]
2026-10-20 Rearrange components on UART sheet, rename battok to batt_ok to avoid warning of similar signal BATTOK
    [PDP-11-CPU-V2-3.kicad_pcb, TOY.kicad_sch, UART.kicad_sch]
2026-10-20 Update Sheet Descriptions
    [CPU.kicad_sch, Memory.kicad_sch, PDP-11-CPU-V2-3.kicad_sch, QBUS.kicad_sch, TOY.kicad_sch, UART.kicad_sch]
2026-10-20 Edit PCB Sheet Description
    [PDP-11-CPU-V2-3.kicad_pcb]
2026-10-30 Add Text for VBAT solder jumper
    [PDP-11-CPU-V2-3.kicad_pcb]
2026-10-31 move label of serial port pinheader to avoid confision as they were adjacanet to an another text
    [UART.kicad_sch]
2026-11-01 Replace SMD footprint for CPU crystal with the handsolder variant
    [CPU.kicad_sch, PDP-11-CPU-V2-3.kicad_pcb]
2026-11-02 Create new footprint for CPU crystal with opitonal TH crystal holes and add DC319 package to 3D
    [CPU.kicad_sch, PDP-11-CPU-V2-3.kicad_pcb]
2026-11-02 Add 3D model for battery holder
    [PDP-11-CPU-V2-3.kicad_pcb]
