cbscpe/PDP-11-CPU-V2-3/(notices)

Notices in the files:
QBUS.kicad_sch:
Copyright Peter Schranz 2026
PDP-11-CPU-V2-3.kicad_pcb:
© Peter Schranz, October 2026
